Scafir/liplib/(commit log)

2025-11-25 initial commit: gf180mcuD pass DRC+LVS
    Matching ESD leakage on the input and output diodes would be good
    [gf180mcu_liplib__asig_guard_5p0.sch, gf180mcu_liplib__asig_guard_sense_5p0.sch, gf180mcu_liplib__no_esd_guarded.sch]
2025-11-26 gf180mcu_liplib: guard sense pad improvement
    Before, a decoupling resistor was missing on the guard line
    between the input and output diodes
    [gf180mcu_liplib__asig_guard_sense_5p0.sch]
2025-11-26 gf180mcu_liplib__asig_guard_sense: add simulations
    [gf180mcu_liplib__asig_guard_sense_5p0_dev.sch, gf180mcu_liplib__asig_guard_sense_5p0_hbm.sch, gf180mcu_liplib__asig_guard_sense_5p0_leakage_sweep.sch, gf180mcu_liplib__asig_guard_sense_5p0_overcurrent.sch]
2025-11-26 gf180mcu_liplib__asig_guard_sense: add core side diode for guard
    [gf180mcu_liplib__asig_guard_sense_5p0.sch, gf180mcu_liplib__asig_guard_sense_5p0_dev.sch]
2025-11-27 gf180mcu_liplib__asig_guard_sense: add cdm simulation
    [cdm_tester.sch, gf180mcu_liplib__asig_guard_sense_5p0_cdm.sch]
2025-11-27 gf180mcu_liplib__asig_guard: separate guard between outer and core section
    [gf180mcu_liplib__asig_guard_5p0.sch]
2025-12-02 Added symbols for 70x100, solved DRC issues, should be all good
    [gf180mcu_liplib__asig_guard_5p0_pad_70x100.sch, gf180mcu_liplib__no_esd_guarded_pad_70x100.sch]
2025-12-02 add gf180mcu_liplib__asig_guard_sense_5p0_pad_70x100_p105.sch
    [gf180mcu_liplib__asig_guard_sense_5p0_pad_70x100_p105.sch]
2025-12-02 gf180mcu_liplib__no_esd_guarded_pad_70x100.sch: add missing caps
    [gf180mcu_liplib__no_esd_guarded_pad_70x100.sch]
